hwdornbush/6-CoaxTester/README.md

# 6-CoaxTester
This project will provide a basic continuity tester and ohmmeter.  It will give us the opportunity to explore how to construct an Arduino project including logic, hardware, and software.
